robot-army/hotstick/README.md

# hotstick
An open-source hardware soldering station
