robot-army/hotstick/Wand/Wand_BOM.xlsx

Ref | Value | Footprint | Ordering code | Manufaturer | Supplier | Qty | Price (1+9) | Total (1+9) | Price (10+99) | Total (10+99) | Min V | Max V | URL
C2, C4, C6 | 100n | Capacitors_SMD:C_0402 |  |  |  | 3 |  | £0.00 |  | £0.00
C5 | 10n | Capacitors_SMD:C_0402 |  |  |  | 1 |  | £0.00 |  | £0.00
C7 | 2.2n | Capacitors_SMD:C_0402 |  |  |  | 1 |  | £0.00 |  | £0.00
D1 | ASMB-MTB0-0A3A2 | Wand:Tri-Colour_LED | 2401105 | AVAGO TECHNOLOGIES | Farnell | 1 | £0.14 | £0.14 | £0.14 | £0.14 |  |  | http://uk.farnell.com/avago-technologies/asmb-mtb0-0a3a2/led-hb-rgb-0-09w-plcc-4/dp/2401105?ost=2401105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
D2 | 3V3 Zener | Resistors_SMD:R_0402
P1 | ISP | Wand:ISP_pads_2x3 |  |  | N/A | 1 | £0.00 | £0.00 | £0.00 | £0.00
P2 | KLB4 | Wand:Jack_3.5mm_KLB | 1200144 | LUMBERG | Farnell | 1 | £1.15 | £1.15 | £1.04 | £1.04 |  |  | http://uk.farnell.com/lumberg/klb-4/connector-rca-jack-3-5mm-3way/dp/1200144?ost=1200144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
P3 | BASE | Wand:Base_Connector |  |  | N/A | 1 | £0.00 | £0.00 | £0.00 | £0.00
R2, R3, R7 | 10K | Resistors_SMD:R_0402 |  |  |  | 3 |  | £0.00 |  | £0.00
R4 | 68R | Resistors_SMD:R_0402 |  |  |  | 1 |  | £0.00 |  | £0.00
R5, R6 | 10R | Resistors_SMD:R_0402 |  |  |  | 2 |  | £0.00 |  | £0.00
U1 | ATMEGA328-MMH | Wand:QFN-28-1EP_4x4mm_Pitch0.45mm | 2066293 | ATMEL | Farnell | 1 | £2.36 | £2.36 | £1.97 | £1.97 | 1.800 | 5.500 | http://uk.farnell.com/atmel/atmega328-mmh/mcu-8bit-atmega-20mhz-qfn-28/dp/2066293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
U2 | MAX31855KASA+ | Housings_SOIC:SOIC-8_3.9x4.9mm_Pitch1.27mm | 2515622 | MAXIM INTEGRATED PRODUCTS | Farnell | 1 | £4.22 | £4.22 | £3.84 | £3.84 | 3.000 | 3.600 | http://uk.farnell.com/maxim-integrated-products/max31855kasa-t/temperature-sensor/dp/2515622
U3 | MPU-6050 | Wand:MPU-6050 | 1864742 | INVENSENSE | Farnell | 1 | £8.65 | £8.65 | £5.90 | £5.90 | 2.375 | 3.460 | http://uk.farnell.com/invensense/mpu-6050/gyro-accel-6-axis-i2c-qfn-24/dp/1864742
 |  |  |  |  |  |  |  | £16.53 |  | £12.89 | 3.000 | 3.460
