robot-army/hotstick/Wand/Wand-Schematic.pdf

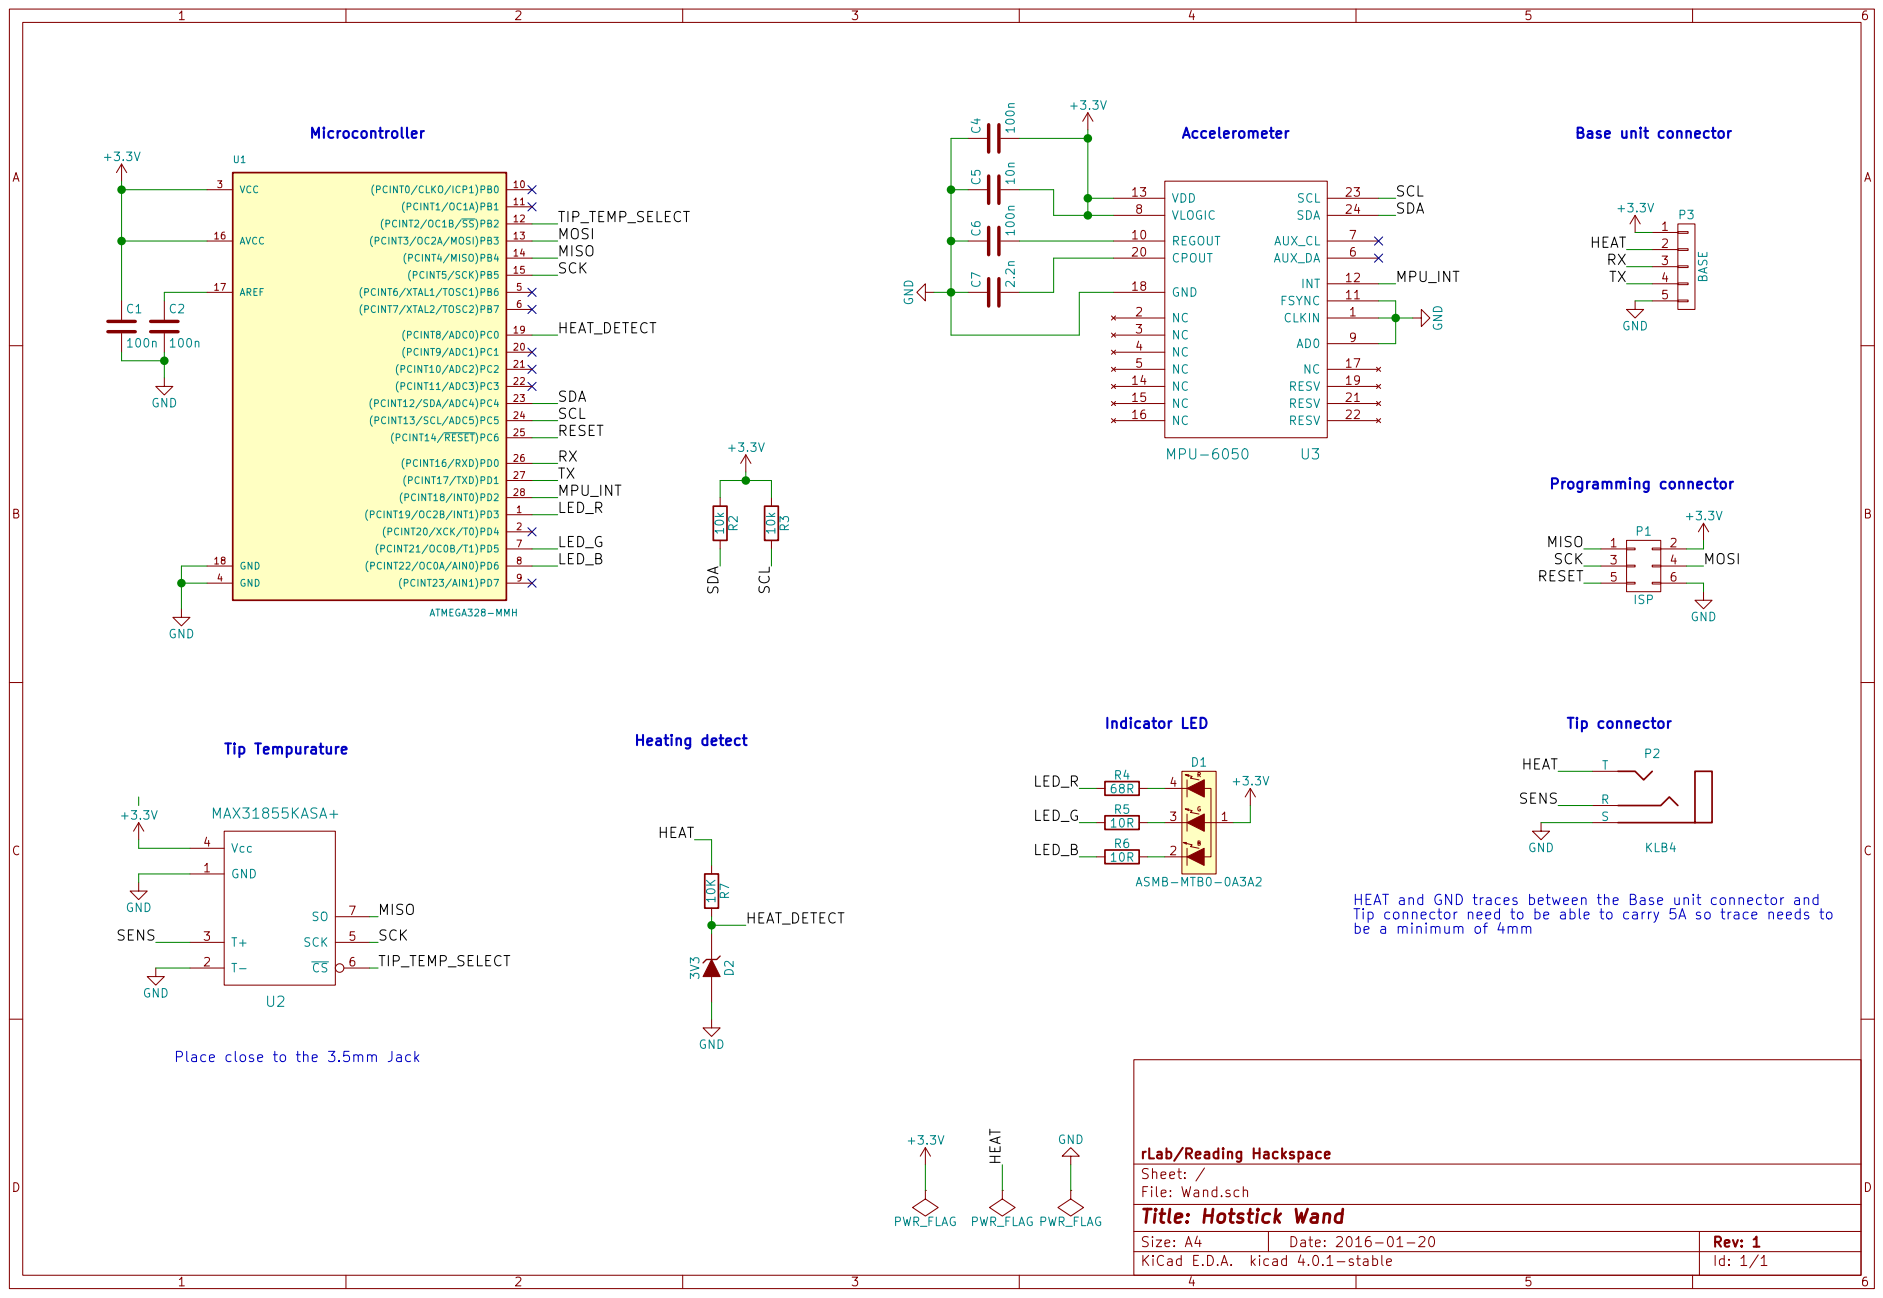
[picture p1: page 1]

SCL
MOSI GND GND HEAT SDA

HEAT and GND traces between the Base unit connector and
Tip connector need to be able to carry 5A so trace needs to be a minimum of 4mm

Place close to the 3.5mm Jack

Id: 1/1 Title: Hotstick Wand
