robot-army/hotstick/Wand/Wand-PCB.pdf

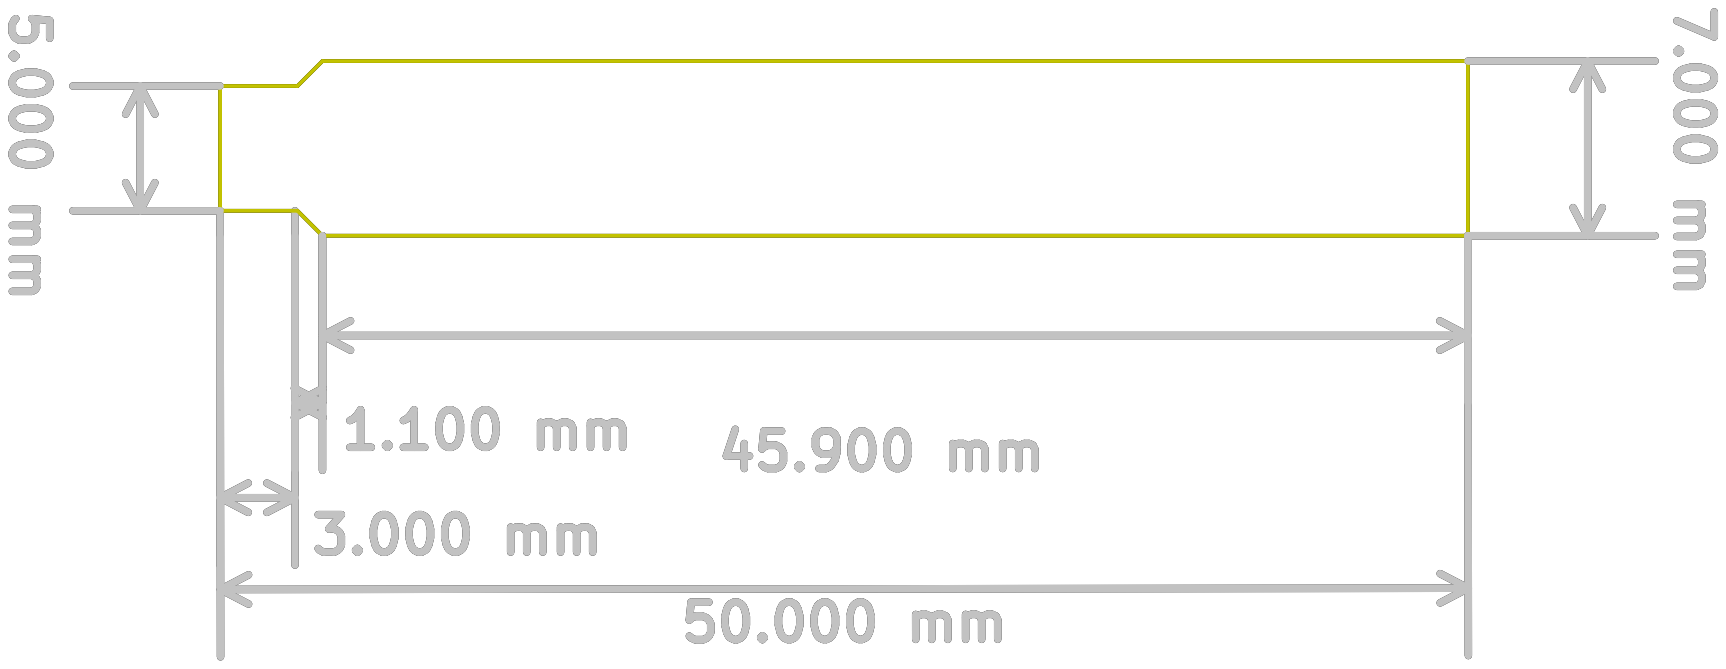
[picture p2: page 5]
