robot-army/hotstick/Wand/Wand.kicad_pcb

## KiCad design Wand/Wand.kicad_pcb (2016-03-27)

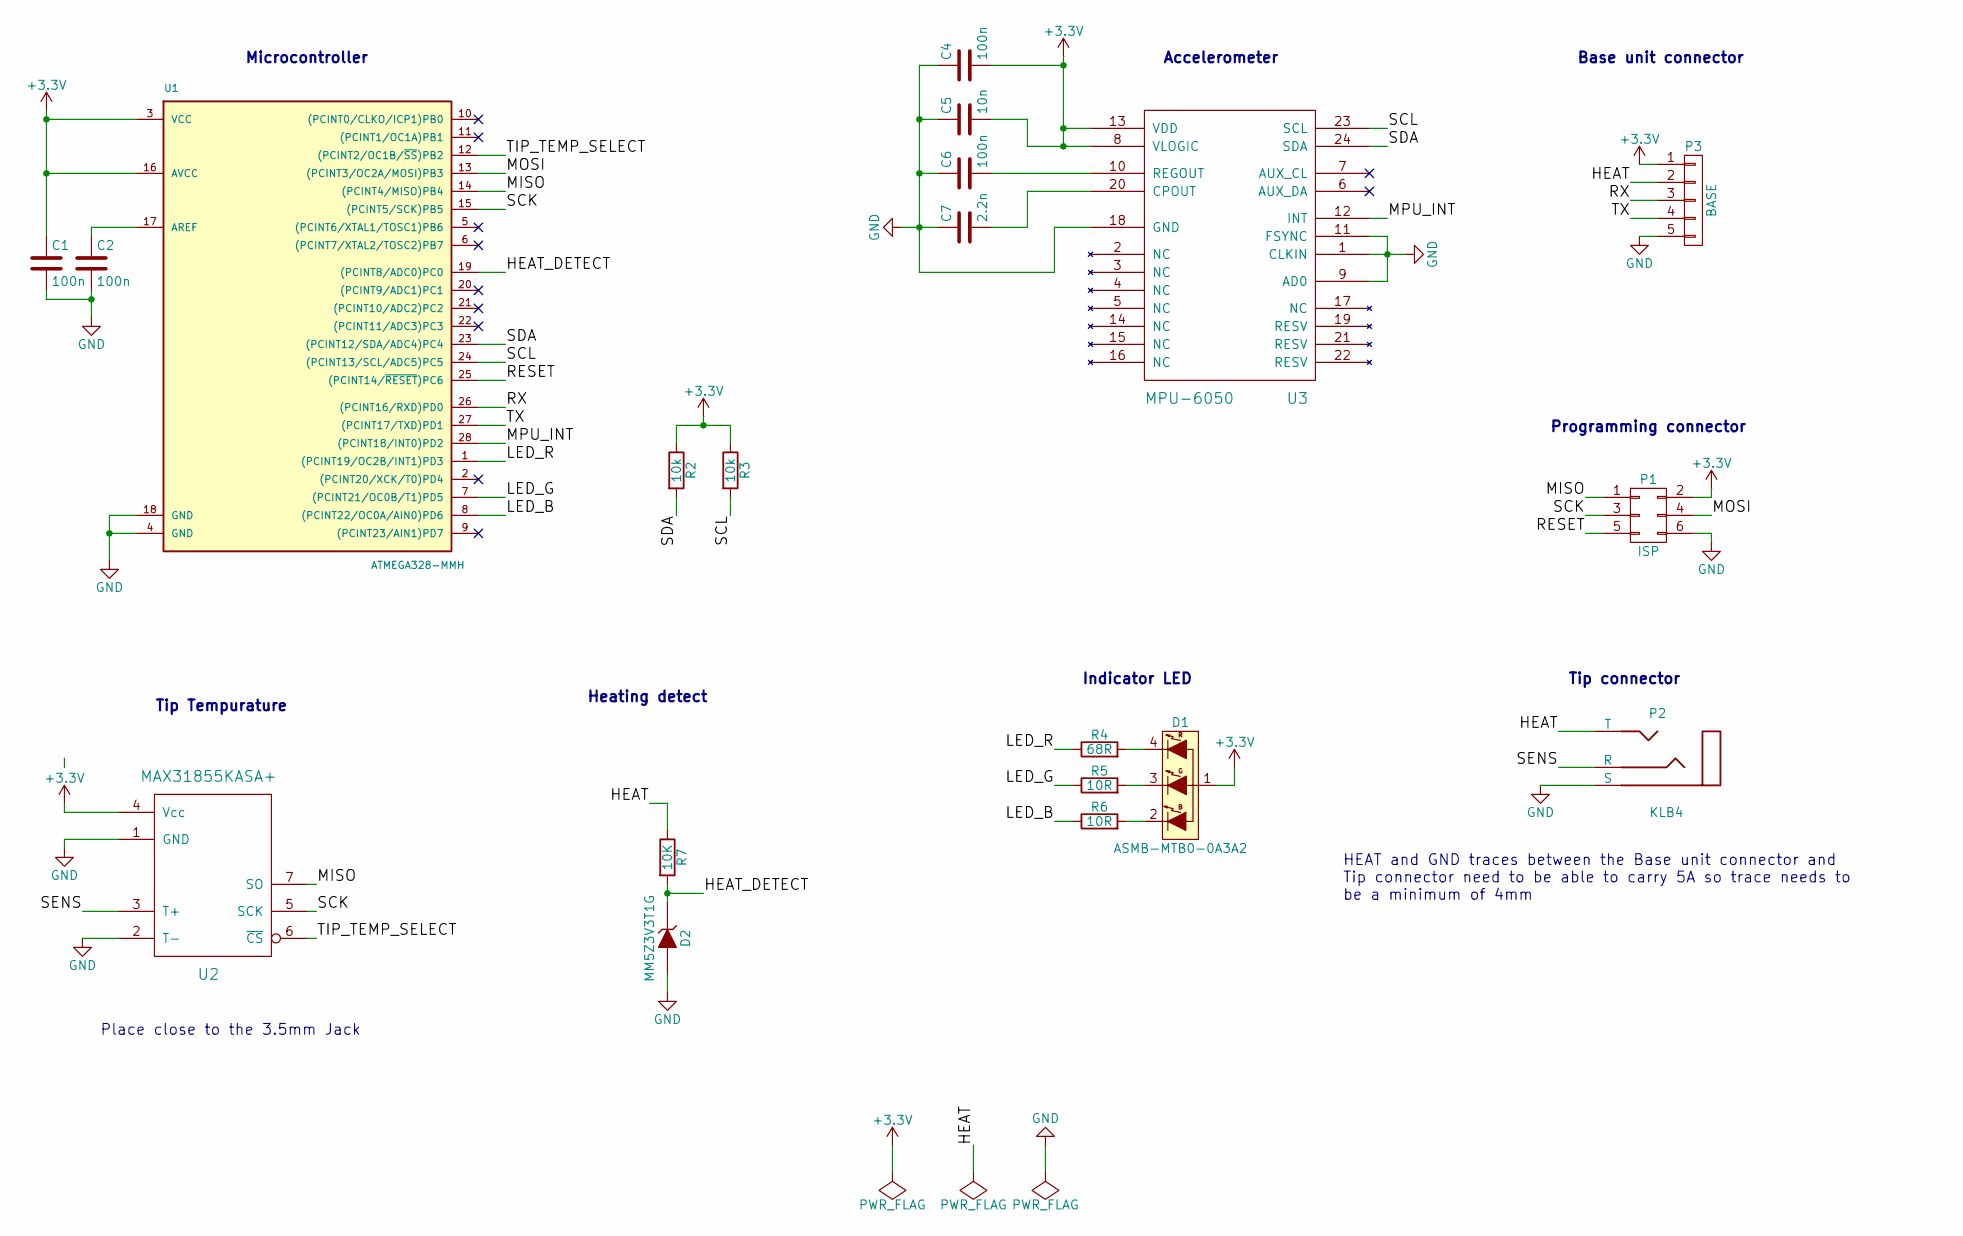
[picture p3: schematic Wand.sch, Hotstick Wand]

Parts:
C1, C2, C4, C6: 100n; C_0402
C5: 10n; C_0402
C7: 2.2n; C_0402
D1: ASMB-MTB0-0A3A2; Tri-Colour_LED
D2: MM5Z3V3T1G; SOD-523
P1: ISP; ISP_pads_2x3
P2: KLB4; Jack_3.5mm_KLB
P3: BASE; Base_Connector
R2, R3: 10k; R_0402
R4: 68R; R_0402
R5, R6: 10R; R_0402
R7: 10K; R_0402
U1: ATMEGA328-MMH; QFN-28-1EP_4x4mm_Pitch0.45mm
U2: MAX31855KASA+; SOIC-8_3.9x4.9mm_Pitch1.27mm
U3: MPU-6050

Connections:
+3V3: C1.1, C4.2, C5.2, D1.1, P1.2, P3.1, R2.1, R3.1, U1.3 (VCC), U1.16 (AVCC), U2.4 (Vcc), U3.8 (VLOGIC), U3.13 (VDD)
/HEAT: P2.T, P3.2, R7.1
/HEAT_DETECT: D2.1 (K), R7.2, U1.19 ((PCINT8/ADC0)PC0)
/LED_B: R6.1, U1.8 ((PCINT22/OC0A/AIN0)PD6)
/LED_G: R5.1, U1.7 ((PCINT21/OC0B/T1)PD5)
/LED_R: R4.1, U1.1 ((PCINT19/OC2B/INT1)PD3)
/MISO: P1.1, U1.14 ((PCINT4/MISO)PB4), U2.7 (SO)
/MOSI: P1.4, U1.13 ((PCINT3/OC2A/MOSI)PB3)
/MPU_INT: U1.28 ((PCINT18/INT0)PD2), U3.12 (INT)
/RESET: P1.5, U1.25 ((PCINT14/~RESET~)PC6)
/RX: P3.3, U1.26 ((PCINT16/RXD)PD0)
/SCK: P1.3, U1.15 ((PCINT5/SCK)PB5), U2.5 (SCK)
/SCL: R3.2, U1.24 ((PCINT13/SCL/ADC5)PC5), U3.23 (SCL)
/SDA: R2.2, U1.23 ((PCINT12/SDA/ADC4)PC4), U3.24 (SDA)
/SENS: P2.R, U2.3 (T+)
/TIP_TEMP_SELECT: U1.12 ((PCINT2/OC1B/~SS~)PB2), U2.6 (~CS)
/TX: P3.4, U1.27 ((PCINT17/TXD)PD1)
GND: C1.2, C2.2, C4.1, C5.1, C6.1, C7.1, D2.2 (A), P1.6, P2.S, P3.5, U1.4 (GND), U1.18 (GND), U2.1 (GND), U2.2 (T-), U3.1 (CLKIN), U3.9 (AD0), U3.11 (FSYNC), U3.18 (GND)
unnamed: C2.1, U1.17 (AREF)
unnamed: C6.2, U3.10 (REGOUT)
unnamed: C7.2, U3.20 (CPOUT)
unnamed: D1.2 (B), R6.2
unnamed: D1.3 (G), R5.2
unnamed: D1.4 (R), R4.2

Notes on the sheet:
Tip connector
Programming connector
Base unit connector
Accelerometer
Microcontroller
Indicator LED
Place close to the 3.5mm Jack
Tip Tempurature
HEAT and GND traces between the Base unit connector and Tip connector need to be able to carry 5A so trace needs to be a minimum of 4mm
Heating detect

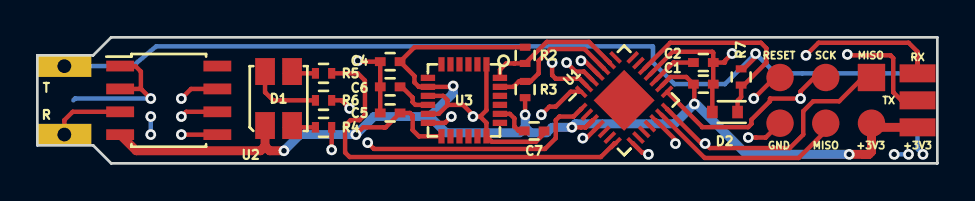
[picture p4: board Wand.kicad_pcb from above]

Board: 4 copper layers, 50.0 x 7.0 mm, 20 parts (1 on the bottom side), 24 nets.
