robot-army/hotstick/(threads)

Thread 10 (2015-10-14):

Measure, record and display power output of iron (wibni)

robot-army, 2015-10-14:
The system should permit measurement, recording and display of the dissipated power at the iron. This is handy for when you're trying to do metrics on soldering production lines (eg. joints/hour etc). Need more detail (x second resolution for x seconds) to define memory requirements etc.

robot-army, 2015-11-05:
Doesn't need a current sensor. Can be done purely with duty cycle, not a hardware requirement.

Closed 2015-11-05.

Thread 11 (2015-10-14):

Power itself off battery for a number of joints

robot-army, 2015-10-14:
Battery power should be provided so the station can be used remotely.

More detail required, how many joints?

jeremypoulter, 2015-10-14:
Could this be satisfied by having a 12V DC power input and/or USB input with DC-DC boost converter?

robot-army, 2015-11-04:
Accommodated by requirement 9

Closed 2015-11-05.

Thread 12 (2015-10-14):

Research other similar projects

robot-army, 2015-10-14:
There are many other projects of this sort. Let's make sure we pick the good bits from them and adhere to their licensing conditions.

Let's either capture these good bits as requirements or methods

robot-army, 2015-10-14:
https://github.com/albert21martins/SolderingStation-master
https://www.youtube.com/watch?v=uHT_JV5KMJI

http://hackaday.com/2015/05/11/hacking-amazing-soldering-features-into-the-already-great-weller-wmrp/
https://github.com/FlyGlas/WMRP

https://debugginglab.wordpress.com/2014/10/30/soldering-station/

https://github.com/ConnyCola/SolderingStation

As a start...

jeremypoulter, 2016-02-02:
This thread also contains some useful info http://dangerousprototypes.com/2012/02/27/weller-rt-type-tip-teardown-and-reverse-engineering/

jeremypoulter, 2016-02-06:
Here is another general purpose soldering controller; http://dangerousprototypes.com/forum/viewtopic.php?f=56&t=7218&p=61175#p61175

jeremypoulter, 2016-04-06:
Just spotted another project to do a Weller RT controller, this one however is trying to get everything in the pencil. Think I like our solution better but could be a good source for reference;

https://hackaday.io/project/10140-soldering-pen

jeremypoulter, 2016-04-23:
Another generic soldering station,this time runing at 110v https://pcbsmoke.wordpress.com/2016/04/21/110v-temperature-controlled-soldering-station-build-no-2/

Thread 14 (2015-10-14):

Iron detection doesn't rely on special holder

robot-army, 2015-10-14:
Tentative requirement. Some irons have eg. accelerometers in the handles to detect an idle iron. Also, some other irons use the power output to detect idle iron.

Closed 2015-11-05.

Thread 15 (2015-10-14):

Display fancy graphics in colour

robot-army, 2015-10-14:

Gavatastic, 2015-10-14:
compatible with a range of displays (to avoid obsolescence if screen component no longer available) [if Arduino based, something like Adafruit's GFX library?]

daubers, 2015-10-14:
How about http://www.adafruit.com/products/358

robot-army, 2015-10-14:
Should we steer away from specific details of implementation for the
moment? What's good about that specific part? Let's capture those good bits
in requirements, and figure out how to implement them in the design stage
of the project yeah?

On Wed, Oct 14, 2015 at 6:45 PM, Matthew Daubney <notifications@github.com>
wrote:

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

Remulos, 2015-10-14:
In that case one of the requirements for the display, as well as the rest of the device, needs to be the simplicity of it's programming. If the main target market is hobbyists and hackspaces then hack-ability is a requirements and some obsucre display which requires an equally obscure driver isn't ideal. Something like the Library is accesable to all and already comes with loads of online reseources.

robot-army, 2015-10-14:
Yep, happy with that additional requirement. I'm sure whatever we end up
choosing won't be esoteric... we do want to be able to make this work,
after all!

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

Closed 2015-11-05.

Thread 16 (2015-10-14):

BOM Cost £80 excluding tip

robot-army, 2015-10-14:
The BOM cost plus the time to build it (at eg.£10/hour), must be cheaper than a WSM 1C, otherwise we might as well just buy one of them.

Approx £330.

http://uk.farnell.com/weller/wsm-1c-uk-eu/soldering-station-40w-230v-battery/dp/1729966

dhprice, 2015-10-14:
Different users will likely have different cost sensitivities. Perhaps have three existing products in each usage category as the one to beat on performance and price.

robot-army, 2015-10-14:
I think we should focus on making one model only.

We can reject certain requirements (eg. battery power) in order to satisfy
the lower cost requirements. That's the only one that I could see us
rejecting for cost sensitivity at the moment...(unless we want to do it
some other way than by using Weller tips, which I wouldn't be stoked about
to be honest, they're REALLY good)

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

Remulos, 2015-10-14:
When looking at components I think that we can save money by avoiding the top spec ones with high degrees of accuracy. Realistically, most applications won't need the iron to be heated to within 5 degrees of the set temperature, more likely to within 10 or 25. We should prioritise ruggedness rather than accuracy.

robot-army, 2015-10-14:
Component choices are going to save us a small percentage rather than tens
or hundreds of pounds overall.

The requirements will set most of the cost. Think battery, colour LCD,
optical encoder for setpoint adjustment, IP/shock and vibration rating, CE
compliance, flammability requirements for materials, that sort of thing is
where the major design decisions will come from.

The idea behind writing this requirement was that if we can't meet this
one, we might as well not do the project.

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

dhprice, 2015-10-15:
But why would a hobbyist pay more than £100? If you design a modular architecture then you could satisfy the pro with a £300 unit and the hobbyist with a £100 unit while retaining a the majority of common features.

robot-army, 2015-10-15:
I paid just about £100 for the first iron I bought as a hobbyist:
http://uk.farnell.com/ersa/i-con-pico/soldering-station-80w-240v-eu/dp/2057377

It's very good, but if we build one with all the listed requirements so far
for even £50 more, it would be by far better value.

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

dhprice, 2015-10-15:
I quite like the look of the pico packaging..

My point is that £150 might be far better value to you but not to someone else so perhaps the approach should be for a design, a platform, that allows people to customise elements that address their prefered values.

robot-army, 2015-10-15:
It's good. Key requirements here that it's missing are the quick-change
tips and the sensible idle modes. The pico watches power output, and if it
sees that you haven't made a joint for x minutes it goes to 250 deg. Then,
it keeps sensing, if it dissipates at 250 that means its had the tip wiped
in the scrubber or seen a light breeze and it quickly comes up to temp.

If it sits at 250 for xx minutes, it shuts down to 60 deg and needs a
button pushed to come back on.

I think the adaptability will be provided for by the open-source nature of
the design. To be honest, it would best capture my interest to design one
product that meets all the requirements we accept, and in future adjust the
requirements for other versions (rather than try to make a 'master of all
trades' first).

To be clear, we don't need to accept all the requirements here! They're
just ideas at this stage and have cost nothing but time so far.
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

dhprice, 2015-11-04:
Accepted

Closed 2015-11-05.

Thread 18 (2015-10-14):

Design for compliance

robot-army, 2015-10-14:
The design work should be undertaken with IEC 60335 (Household and similar electrical appliances) standards in mind.

robot-army, 2015-10-14:
Let's start with a review of the standard and make sure that a) this is the right one and b) we've got a hope in hell of meeting it!!

Remulos, 2015-10-15:
The specific standard would be IEC 60335-2-45 "Household and similar electrical appliances – Safety – Part 2-45: Particular requirements for portable heating tools and similar appliances".

I can provide a copy of the standard if we keep it confidential, i.e. no publishing it on open access sites like the google group/ wiki/ Github

Remulos, 2015-10-15:
Here is the full IEC 60335-1 document, I don't think that it includes the latest amendment but that's to do with microwave ovens or something so not relevant.
http://www.anbotek.com.cn/standard/(%E5%AE%B6%E7%94%B5)Household-EN%2060335-1_2012.pdf

I've taken a look at Part 2-45 and made a note of all the differences relevant to a soldering iron and attached here. This is for a Soldering Iron and not a Soldering Gun or an Induction Soldering iron.

With regards to compliance as a whole, the requirement for this product really just depends on the end goal. It's always a good idea to design for compliance but if we're not selling it then we don't need to actually get it tested. If we're selling it by mail order to 20 people a year then we don't need to test it. If we're going to sell it on the Sparkfun website or whatever then we will need to go through the whole compliance process. You don't need to get any sort of certification for the schematic if we publish it online and can't be held liable for anything if we publish it and it hurts someone who has built it. We can be held liable if we manufacturer it and sell it as a kit, regardless of whether it's open-source or not.
[IEC 60335-2-45 Gap Analysis.pdf](https://github.com/robot-army/hotstick/files/14050/IEC.60335-2-45.Gap.Analysis.pdf)

robot-army, 2015-10-15:
Excellent! Nice work!

So, I guess the key thing is to extract all the relevant requirements from
these document and turn them into bite-sized manageable requirements?

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

Remulos, 2015-10-15:
Yer the standard is about 200 pages long but a lot of it is just about how the tests should be carried out. I am looking now and will see how long it'll take me to put together a concise requirements list.

robot-army, 2015-10-15:
That's a seriously arduous task I just suggested. This document is weighty.

Key question is all this jazz about supply cords. What do we gain by using
an external 'brick'? Is that a type X, Y or Z attachment?? What class are
we in? 0, 0l?

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

robot-army, 2015-10-15:
Where do I find 60335-2-45? It seems we've only got -1

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
>>> Here is the full IEC 60335-1 document, I don't think that it includes
>>> the latest amendment but that's to do with microwave ovens or something so
>>> not relevant.
>>>
>>> http://www.anbotek.com.cn/standard/(%E5%AE%B6%E7%94%B5)Household-EN%2060335-1_2012.pdf
>>>
>>> I've taken a look at Part 2-45 and made a note of all the differences
>>> relevant to a soldering iron and attached here. This is for a Soldering
>>> Iron and not a Soldering Gun or an Induction Soldering iron.
>>>
>>> With regards to compliance as a whole, the requirement for this product
>>> really just depends on the end goal. It's always a good idea to design for
>>> compliance but if we're not selling it then we don't need to actually get
>>> it tested. If we're selling it by mail order to 20 people a year then we
>>> don't need to test it. If we're going to sell it on the Sparkfun website or
>>> whatever then we will need to go through the whole compliance process. You
>>> don't need to get any sort of certification for the schematic if we publish
>>> it online and can't be held liable for anything if we publish it and it
>>> hurts someone who has built it. We can be held liable if we manufacturer it
>>> and sell it as a kit, regardless of whether it's open-source or not.
>>> IEC 60335-2-45 Gap Analysis.pdf
>>> <https://github.com/robot-army/hotstick/files/14050/IEC.60335-2-45.Gap.Analysis.pdf>
>>>
>>> —
>>> Reply to this email directly or view it on GitHub
>>> <https://github.com/robot-army/hotstick/issues/18#issuecomment-148386714>
>>> .
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

Remulos, 2015-10-15:
I couldn't download it so I just took out all the bits pertinent to this project and put them in the pdf I attached. That pdf is all that is needed beyond  60335-1 unless we want to add a heat gun or the soldering iron is going to contain a transformer.

robot-army, 2015-10-15:
OK cool!

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

robot-army, 2015-11-05:
This is not a requirement, but it will spill out into other requirements. Looking forward to seeing what @remulos gets done

Thread 20 (2015-10-14):

ambient light detection for shutdown

dhprice, 2015-10-14:
Detect when there is no ambient light (LDR) and shutdown the iron (capturing Bob's requirement from the earlier email thread)

robot-army, 2015-10-14:
Good shout, thanks David.

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

Gavatastic, 2015-10-14:
Mounted in a way that

Gavatastic, 2015-10-14:
Mounted so that it is not triggered by the screen

Remulos, 2015-10-15:
This is a good idea.

dhprice, 2015-11-04:
Requirement is avoiding violations of rule zero. Possibly satisfied by detecting lack of handle motion, etc.

Closed 2015-11-05.

Thread 21 (2015-10-14):

Auxiliary software controlled switch

jeremypoulter, 2015-10-14:
We could add an auxiliary output/switch to control external equipment to turn on when the iron is on  and/or out of the holder.

This could be used to switch on lighting, extraction or fan.

Could be as simple as a relay.

robot-army, 2015-10-14:
Oooo yes some opto-isolated GPIO's would be very handy!

On Wed, Oct 14, 2015 at 6:24 PM, Jeremy Poulter <notifications@github.com>
wrote:

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

plett, 2015-10-14:
Do we need to design that in to the board and increase the BOM, or just expose an I2C/SPI/whatever header and let people design their own relay board and patch the software to drive it?

robot-army, 2015-10-14:
I don't think there's a requirement for relays, but I think there's a
strong requirement for all the IO to be robust against ESD, overvoltage,
short circuit etc, and no requirement for it to be particularly fast or low
power.

On Wed, Oct 14, 2015 at 7:33 PM, Paul Lettington <notifications@github.com>
wrote:

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

robot-army, 2015-10-14:
What I mean by that, is that any IO on board should be optoisolated.

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

jeremypoulter, 2015-10-14:
Essentially my use case for this was that I always forget to turn on my fan when soldering it would be really handy if the soldering station automatically switched this on, but generally any unused GPIO (suitably isolated) where available that would be sufficient.

IC2 and SPI I think would be god, but IMHO I would just have these on an internal header rather than externally accessible as these probably would be only useful for custom expansions. The GPIO could have some built in 'if this then that' controls in the generic firmware, eg when iron removed from folder trun on aux 1.

Remulos, 2015-10-15:
I agree that this would be a really useful feature and does help to differentiate it from other irons but maybe this is a low priority requirement? Review a preliminary design once we have one and see if it's possible rather than making it an absolute requirement.

I also agree that the I2C and SPI should be on an internal header, that way we could quite easily allow for a number of different addresses using jumpers.

dhprice, 2015-11-04:
Accepted, it'll be nice to have some external device control broken out on headers on the PCB. Need to think about this for compliance.

Closed 2015-11-05.

Thread 4 (2015-10-14):

Decide on a software license

robot-army, 2015-10-14:

jeremypoulter, 2015-10-14:
I normally use the Acache license or BSD license. The latter (BSD) is a nice simple which I quite like. The Apache license is also not bad and has some requirements about granting licenses to use any IPR that are not in other OSS licenses.

I would avoid GPL on principle, as it is totally hypocritical (especially v3). How can you preach that your license promotes choice while removing peoples choice at the same time... ?

plett, 2015-10-14:
It seems sensible to me for the software licence to have similar clauses to the hardware licence so the two parts can be used together by any potential manufacturers.

As per the other issue, we've picked CERN OHL 1.2 for the hardware licence. According to  http://www.ohwr.org/projects/cernohl/wiki "CERN–OHL is to hardware what the General Public Licence (GPL) is to software".

IANAL, but reading through http://www.ohwr.org/attachments/2388/cern_ohl_v_1_2.txt seems to say that it allows people to manufacture devices based on the hardware but that they must publish the design of the hardware they make. The closest software licence that I know of that meets the same clause is GPL. For personal reasons, I'd prefer GPLv2 over GPLv3.

robot-army, 2015-11-05:
I think one important goal with all the licensing stuff on here is to avoid the **** that happened with Arduino. I hope we can all learn from that mess.

Thread 5 (2015-10-14):

Decide on a license for branding

robot-army, 2015-10-14:

daubers, 2015-10-14:
https://creativecommons.org/choose/ :)

robot-army, 2015-11-05:
I think one important goal with all the licensing stuff on here is to avoid the **** that happened with Arduino. I hope we can all learn from that mess.

Thread 6 (2015-10-14):

Drive a single Weller eg. RT1 tip

robot-army, 2015-10-14:

robot-army, 2015-10-14:
Need more detail here: Current, voltage, connector and other physical interface details

daubers, 2015-10-14:
I can't actually find anything about an RP1 tip???

ribbotson, 2015-10-14:
Shouldn't this be an RT1 tip ?

robot-army, 2015-10-14:
Must be a typo! Sorry!

http://www.apexhandtools.com/weller/PDFs/Weller%20WX%20brochure%20US.pdf
lists all the tips available for WXMP irons.

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

plett, 2015-10-14:
http://dangerousprototypes.com/2012/02/27/weller-rt-type-tip-teardown-and-reverse-engineering/ (and http://dangerousprototypes.com/forum/viewtopic.php?f=19&t=3583 ) documents a teardown on a RT1 tip.

It apparently uses a 3-pin stereo headphone jack (unclear if 2.5mm or 3.5mm) for +v, GND and temp sense, with a k-type thermocouple which you read when power isn't being applied.

robot-army, 2015-11-04:
The system needs to be able to drive these tips at the maximum power.

Closed 2015-11-05.

Thread 8 (2015-10-14):

Allow adjustment of temperature setpoint by rotary encoder with detents

robot-army, 2015-10-14:
The hardware should provide for adjustment of the temperature setpoint

dhprice, 2015-10-14:
Digital vs analogue?
rotary encoder vs up/down buttons?
presets for different work profiles?

robot-army, 2015-10-14:
Yep, all of that. Personally I'll always prefer a nice optical encoder. Maybe a few buttons for profiles as well? I don't really use them, even when present, but maybe that's just me.

Closed 2015-11-05.

Thread 9 (2015-10-14):

System power input DC, 12-24 V with as common a connector as we can manage.

robot-army, 2015-10-14:
The unit should be able to be powered off any worldwide standard mains supply

dhprice, 2015-10-14:
are soldering irons AC to the tip or is it worth considering DC via a laptop brick?

robot-army, 2015-10-14:
The Weller tips are 12 Volt DC to the tip. An external brick would be a
great approach, I think it'd likely be the best way actually, especially
given the requirement to design for compliance. Let's not worry too much
about implementation at this stage, this requirement was to exclude other
requirements like powering it off USB.

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

Closed 2015-11-05.

Thread 25 (2015-10-15):

Decide on Documentation licence

dhprice, 2015-10-15:
This should be at least as permissive as the software and hardware licences.

I suggest Creative Commmons  Attribution-ShareAlike International -  CC BY-SA 4.0

"This license lets others remix, tweak, and build upon your work even for commercial purposes, as long as they credit you and license their new creations under the identical terms. This license is often compared to “copyleft” free and open source software licenses. All new works based on yours will carry the same license, so any derivatives will also allow commercial use. This is the license used by Wikipedia, and is recommended for materials that would benefit from incorporating content from Wikipedia and similarly licensed projects."

http://creativecommons.org/licenses/by-sa/4.0/

plett, 2015-10-16:
IANAL, but CC BY-SA seems like a good match to the CERN OHL which has already been chosen for the hardware licence. Sounds good to me.

dhprice, 2015-11-04:
Yeah, do this.

dhprice, 2015-11-04:
Or don't? Who cares?

robot-army, 2015-11-05:
I think one important goal with all the licensing stuff on here is to avoid the **** that happened with Arduino. I hope we can all learn from that mess.

Thread 26 (2015-10-15):

Ergonomics requirements

dhprice, 2015-10-15:
A key requirement and an umbrella category.

From a discussion with Richard we should address the ergonomics requirements of the controller and especially the handset.

How do we capture and define the requirements for the handset, meaning the tip, handle and cable? These characteristics will determin how "nice"/comfortable the unit is to use over a period.

For example, the cable on my Antex is very irritating requiring me to spend too much effort to arrange and manage while soldering. This bears on the cable material (slicone ?), thickness, weight and length.

robot-army, 2015-10-15:
Great, yep. This one is a tricky thing to capture. I think we should
require the cable to be very flexible and heatproof, and we should have the
base unit suitably heavy and sturdy, maybe that's a good start?

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

Remulos, 2015-10-15:
This a requirement that could really benefit from a sort of show and tell of the soldering irons we have. It's hard to quantify ergonomics in a way that makes sense to everyone so I would suggest we try to gather an array of irons and physically try each of them out one night.

robot-army, 2015-10-15:
Good idea, I'll bring my i-con pico. Maybe Bob Dunlop can bring one of the
wellers from my old work, and I think there's a Hakko at the space already.

Maybe we can make this coincide with the requirements review, and do that
in person/via webcast realtime.

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

Remulos, 2015-10-15:
I'll bring my £40 Maplin iron as an example of what NOT to do.

jeremypoulter, 2015-10-15:
I have a Hakko I can bring in.
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

dhprice, 2015-11-04:
Duplicate as near as dammit the weller handset and cable in terms of dimensions, weight, flexibility of cable.

dhprice, 2015-11-04:
Ergonomic requirements for the basestation is the rotary encoder with detents to change temperature etc quickly.

robot-army, 2015-11-05:
Captured in other requirements (handle mass, cable flexibility and rotary encoder). Duplicate.

Closed 2015-11-05.

Thread 27 (2015-10-15):

Provide an SD card slot

Gavatastic, 2015-10-15:
Collect data on how it is used (temps/duration) to better understand why rLab solder stations have limited life

robot-army, 2015-10-15:
Totally, this is part of measuring and recording current.

On Thu, Oct 15, 2015 at 8:45 AM, Gavatastic <notifications@github.com>
wrote:

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

Remulos, 2015-10-15:
What sort of range would you want to store? Full lifecycle stats (i.e. 10,000 uses or something) might exceed basic micro controller memory.

dhprice, 2015-10-15:
£2.50 or so for an ESP8266 WiFi serial interface ... you could store the
data anywhere you like.

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

Remulos, 2015-10-15:
If we're putting wireless in this thing then we'll have to look at some extra compliance requirements so we should figure this one out soon.

robot-army, 2015-10-15:
Oh man, intentional radiators :)

I'd much rather an SD card or something

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

robot-army, 2015-10-15:
but again, implementation is not for now. If we want to store stuff, we can
make it a requirement and figure out how to implement it 'soon'.

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

Gavatastic, 2015-10-15:
Need not take to much memory if we're only storing and adjusting aggregate stats. The key thing would be to decide which one - no of usages, duty rate, length of low power periods ie are people just lazily leaving it on etc (not an expert on what would be best)

I like the idea of transmitting them for storage elsewhere, but think it's probably a lower priority requirement?

-----Original Message-----
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

robot-army, 2015-10-15:
I really don't like the idea of wireless transmissions if we're going to
try to get this thing past any real compliance or type approval testing.

I'm not saying that we definitely WILL, but designing that in will make it
potentially a LOT more difficult if we do.

On Thu, Oct 15, 2015 at 12:33 PM, Gavatastic <notifications@github.com>
wrote:

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

Remulos, 2015-10-15:
I have to agree, I like wireless in everything as much as the next guy but working for UL means I know how much of a complete pain in the arse it can be and I don't think it's worth it. SD card would work though.

dhprice, 2015-10-15:
Remind me why do we need to get compliance approval for an open source
design?

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

Remulos, 2015-10-15:
If you intend to sell it you need compliance approval, regardless of the copyright or lack thereof. Licencing is not Regulation.

robot-army, 2015-10-15:
Because I'd like a product that can be 'put in to service'.

In my opinion, one big thing that's missing from open-source hardware is
standards compliance.

It can be found in software (eg. POSIX), why not hardware?

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

dhprice, 2015-10-15:
I fully understand that aspect, it was not made clear that the goal is
to build a sellable product.

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

robot-army, 2015-10-15:
To clarify "If you intend to sell it you need compliance approval" - Not
only if you intend to sell it, but if you intend to put it in to service. I
think that's the wording, there's not many exemptions.

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

robot-army, 2015-10-15:
Here's a quote from (a biased) interpretation the machinery directive, not
sure if it applies to the applicable directives for this product but...

"The Directive and the European guidance makes it very clear that Machinery
built for own use must be CE marked"

http://www.cemarkingassociation.co.uk/machinery-built-for-own-use-ce-marking/

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

robot-army, 2015-10-15:
Can we move this thread of discussion over to the compliance requirement
issue please?

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

jeremypoulter, 2015-10-15:
There are versions of the ESP8266 modules that come pre-certified, but that
being said I think maybe an SD card would be more appropriate for this task.
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

Remulos, 2015-10-15:
The end product would still need to be tested to the EMC standard EN 301 489-1

dhprice, 2015-11-04:
V. nice to have.

robot-army, 2015-11-05:
Hardware requirement is provide some removable data storage. Is this one accepted? I can't remember.

jeremypoulter, 2015-11-05:
I think it was. This would also be really useful in the dev stage for
debugging as well.

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

robot-army, 2015-11-05:
OK

Closed 2015-11-05.

Thread 29 (2015-11-05):

Design in a way that the output stage and temperature sense can be easily replaced to drive other handles/irons

robot-army, 2015-11-05:

Closed 2015-11-05.

Thread 34 (2015-11-11):

Accelerometer feasibility study

jeremypoulter, 2015-11-11:
I think it would be an idea to do a feasibility study and try and answer the following;
1) Can we fit all the required components on to a PCB no wider than around 7-8mm?
2) Would such a board be practical to manufacturer at rLab?
3) What would need to be out sources?
4) Could the cost of the board be <= £10?

jeremypoulter, 2016-01-29:
I think we have a good design for the handle PCB that at least satisfies requirement 1). It is however over the budget set in 4) at approx £15 to £20

Thread 36 (2015-11-11):

Gesture control

jeremypoulter, 2015-11-11:
On the assumption that we have an accelerometer in the iron how about some gesture control? For example maybe a quick flick up could raise the temperature or down could lower the temp? Shake to force off?

robot-army, 2015-11-11:
Cool!!!
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

Thread 39 (2015-12-17):

Change to use Cold-Junction Compensated Thermocouple-to-Digital Converter

jeremypoulter, 2015-12-17:
I have just noticed that Adafruit have a breakout board for an all in one Thermocouple Amplifier with build in cold junction compensation (https://www.adafruit.com/products/269). This is based on the MAX31855 (https://www.maximintegrated.com/en/products/analog/sensors-and-sensor-interface/MAX31855.html). Will definitely reduce the complexity and component count but may increase cost.

What do people think?

jeremypoulter, 2016-01-19:
Went ahead with this and have confirmed it works

Closed 2016-01-19.
