robot-army/hotstick/(commit log)

2015-11-09 Initial schematic for a prototype soldering iron with accelerometer and micro controller in the handle of the iron
    [Wand.kicad_pcb, Wand.sch]
2015-11-14 Changed logic voltage to 3.3V as the MCP-6050 is 3,3v (as are most accelerometers)
    [Wand.sch]
2015-11-14 Use UART to communicate with the base unit, should be more reliable than I2C over long (1-2m).
    [Wand.sch]
2015-11-14 Added the support passive components for the MPU-6050.
    [Wand.sch]
2015-11-14 Corrected the ATMega 328 part number, needed the 28-pin VQFN package 4x4mm
    [Wand.sch]
2015-11-14 Picked an RGB LED part and selected the correct resistor values
    [Wand.sch]
2015-11-14 Fixed a 5v that should be 3.3v
    [Wand.sch]
2015-11-17 Added logic to detect the tip being inserted
    [Wand.sch]
2015-11-17 Added TMP100 temp sensor to measure the temp at the cold junction.
    [Wand.sch]
2015-11-18 General tidy-up and added a 100nF cap on AREF.
    [Wand.sch]
2015-11-20 Updated the Op-amp for the smaller OPA336N version
    [Wand.sch]
2016-01-03 Added a few footprints
    [Wand.sch]
2016-01-04 Corrected the schematic to use the 28pin version of the ATMEGA 328
    [Wand.sch]
2016-01-04 Added project specific footprint library
2016-01-04 Footprint for ATMega328-MM
    [Wand.sch]
2016-01-04 Added footprint for the LED
    [Wand.sch]
2016-01-11 Changed 3.5mm jack to an EBS35 style jack as a) I have some and b) some one had already done the footprint
    [Wand.sch]
2016-01-11 Set the footprint of the 3.5mm socket
    [Wand.sch]
2016-01-12 More 3.5mm Jack data sheets
2016-01-12 Another day, another 3.5mm Jack. This time just a basic panel mount one. The PCB mount ones are not going to fit in the required form factor.
    [Wand.sch]
2016-01-12 Removed the crystal and took a few changes to match the RFm69Pi module from Open Energy Monitor as that works with Serial and no crystal.
    [Wand.sch]
2016-01-13 Changed over to using the MAX31855 for reading the temperature to reduce the component count and also make virtually all the wand digital signals
    [Wand.sch]
2016-01-13 Exact part number for the Tip temp sensor
    [Wand.sch]
2016-01-13 Updated PDF to match latest circuit.
2016-01-18 Corrected the MAX31855 chip select line, should be D10 (pin 12) not pin 10
    [Wand.sch]
2016-01-18 Test sketches for the LED and thermocouple
2016-01-19 Simple test for the Accelerometer
2016-01-20 Custom footprints for the base and 3.5mm Jack
    [Wand.sch]
2016-01-20 Updated the PDF of the schematic
2016-01-20 Connected the MPU interrupt, needed by the http://www.i2cdevlib.com/ library for the MPU-6050
    [Wand.sch]
2016-01-20 Initial PCB layout, still work in progress.
    [Wand.kicad_pcb, Wand.sch]
2016-01-21 Sorted out the trace for the tip power and finalised the rest of the layout for review
    [Wand.kicad_pcb]
2016-01-21 Slight tweak to allow more copper for tip power rail
    [Wand.kicad_pcb]
2016-01-21 Another small tweak to tip Power rail
    [Wand.kicad_pcb]
2016-01-21 Yet more tweaks to tip power
    [Wand.kicad_pcb]
2016-01-23 Tidy up of the silk screen
    [Wand.kicad_pcb]
2016-01-24 Added back silk screen info
    [Wand.kicad_pcb]
2016-01-26 Some more tidy ups
    [Wand.kicad_pcb]
2016-01-26 Final (hopefully) tweaks to the silk screens
    [Wand.kicad_pcb]
2016-01-28 Removed the capacitor from the Temp sensor to allow it to be centred and initial modifications to allow monitoring of when the tip is being heated.
    [Wand.kicad_pcb, Wand.sch]
2016-01-29 Removed reset pull-up (should not be needed as internally pulled up) to make room for the heat detect logic and layed out the remaining components for the heat detect.
    [Wand.kicad_pcb, Wand.sch]
2016-01-29 Updated to match the checked in schematic/layout
2016-01-29 Its d BOM
    [Wand_BOM.xlsx]
2016-01-29 Added Gerber files for rev 1
    [Wand-B.Mask.gbr, Wand-B.Power.Cu.gbr, Wand-B.SilkS.gbr, Wand-Edge.Cuts.gbr, Wand-F.Mask.gbr, Wand-F.Paste.gbr, Wand-F.Signal.Cu.gbr, Wand-F.SilkS.gbr]
2016-03-27 Changed 0402 to sod-523 for Zener
    [Wand.kicad_pcb, Wand.sch]
2016-03-27 Finished change for 0402, also generated fabrication data
    [Wand.kicad_pcb, Wand.sch]
2016-03-27 Added production data for dirtyPCBs order 2019353
    [Wand-B.Mask.gbs, Wand-B.Power.Cu.gbl, Wand-B.SilkS.gbo, Wand-F.Mask.gts, Wand-F.Paste.gtp, Wand-F.Signal.Cu.gtl, Wand-F.SilkS.gto, Wand-NPTH.drl]
